First-cmd/SOLAR-ENERGY-MONITORING-AND-MANAGEMENT-SYSTEM-USING-INA228-ON-THE-HOME-ASSISTANT-PLATFORM/SOLAR ENERGY MONITORING AND MANAGEMENT SYSTEM USING INA228 ON THE HOME ASSISTANT PLATFORM#.pdf

The 15th Asia Undergraduate Conference on Computing (AUC²
) 2027

## ระบบตรวจวัดและจัดการพลังงานแสงอาทิตย์ด้วย INA228 บนแพลตฟอร์ม Home Assistant SOLAR ENERGY MONITORING AND MANAGEMENT SYSTEM USING INA228 ON THE HOME ASSISTANT PLATFORM

สิริชัย วงศ์สร้างสรรค์ และ สิทธิโชค อุ่นแก้ว

สาขาวิชาวิศวกรรมคอมพิวเตอร์ คณะวิศวกรรมศาสตร์ มหาวิทยาลัยเทคโนโลยีราชมงคลศรีวิชัย Email: sirichai.u@rmutsvmail.com,sirichai.u@rmutsvmail.com

บทคัดย่อ
โครงงานนี้มีวัตถุประสงค์เพื่อพัฒนาระบบตรวจวัดและจัด การพลังงานแสงอาทิตย์ด้วยเซนเซอร์ร่วมกับระบบผู้ช่วยควบคุม บ้านอัจฉริยะสําหรับติดตามแรงดันไฟฟ้า กระแสไฟฟ้า กําลังไฟฟ้า และพลังงานสะสมของระบบไฟฟ้ากระแสตรง โดยส่ง ข้อมูลจากชุดตรวจวัดไปแสดงผลบนแดชบอร์ด เพื่อให้ผู้ใช้งาน ติดตามสถานะและควบคุมการทํางานของระบบได้ ระบบ ประกอบด้วยส่วนตรวจวัด ส่วนประมวลผล และชุดรีเลย์ควบคุม การเชื่อมต่อระหว่างแบตเตอรี่กับคอนโทรลชาร์จเจอร์รวมถึง ควบคุมโหลดสําหรับใช้พลังงานส่วนเกิน ผู้ใช้งานสามารถเลือก สั่งงานรีเลย์ด้วยตนเองหรือเปิดโหมดจัดการพลังงานส่วนเกิน แบบอัตโนมัติตามเงื่อนไขที่กําหนด การประเมินระบบครอบคลุม การเปรียบเทียบค่าที่วัดได้กับเครื่องมืออ้างอิง การตรวจสอบการ แสดงผลบน ผู้ช่วยควบคุมบ้านอัจฉริยะ และการทดสอบการ ควบคุมรีเลย์ทั้งสองโหมด โดยมุ่งให้ได้ระบบต้นแบบที่ช่วย ติดตามการใช้พลังงานและจัดสรรพลังงานส่วนเกินให้เหมาะสม กับโหลด
คําสําคัญ: พลังงานแสงอาทิตย์, ผู้ช่วยควบคุมบ้านอัจฉริยะ, การ จัดการพลังงาน, พลังงานส่วนเกิน

ABSTRACT
This project aims to develop a solar energy monitoring and management system using the sensor integrated with Home Assistant. The system monitors DC voltage, current, power, and accumulated energy and displays the measurements on a dashboard for status monitoring and control. It consists of sensing and processing units and relays that control the connection between the battery and charge controller, as well as a load for surplus energy utilization. Users can operate the relays manually or enable automatic surplus energy management according to predefined conditions. System evaluation includes comparing measurements with reference instruments, verifying data display in Home Assistant, and testing relay operation in both modes. The intended outcome is a prototype that supports energy monitoring and allocates surplus solar energy to suitable loads.
Keywords: Solar Energy, Home Assistant, Energy Management, Surplus Energy

### 1. บทนํา

พลังงานแสงอาทิตย์เป็นพลังงานทดแทนที่สามารถนํามาใช้ ผลิตไฟฟ้าสําหรับอุปกรณ์และระบบต่าง ๆ ได้ อย่างไรก็ตาม ปริมาณพลังงานที่ผลิตได้เปลี่ยนแปลงตามสภาพแสงและ ช่วงเวลา ขณะที่ความต้องการใช้ไฟฟ้าของโหลดอาจไม่สอดคล้อง กับกําลังการผลิต การตรวจวัดค่าทางไฟฟ้าและการจัด การพลังงานจึงเป็นส่วนสําคัญในการติดตามสถานะของระบบ และวางแผนใช้พลังงานให้เหมาะสม โดยเฉพาะระบบที่มี แบตเตอรี่สําหรับเก็บพลังงานและจ่ายไฟให้โหลดในช่วงที่กําลัง การผลิตไม่เพียงพอ
การตรวจสอบแรงดันไฟฟ้าเพียงอย่างเดียวไม่สามารถแสดง การไหลของพลังงานได้ครบถ้วน จึงควรพิจารณากระแสไฟฟ้า กําลังไฟฟ้า และพลังงานสะสมร่วมด้วย ข้อมูลเหล่านี้ช่วยให้ ผู้ใช้งานทราบสถานะการผลิตและการใช้พลังงาน รวมถึงใช้ ประกอบการกําหนดเงื่อนไขควบคุมโหลด เมื่อระบบมีพลังงาน ส่วนเกิน การนําพลังงานดังกล่าวไปใช้กับโหลดที่เหมาะสมต้อง คํานึงถึงสถานะแบตเตอรี่และเงื่อนไขการทํางานของระบบด้วย โครงงานนี้จึงมุ่งพัฒนาระบบตรวจวัดและจัดการพลังงาน แสงอาทิตย์ด้วยเซนเซอร์ INA228 ร่วมกับ Home Assistant [2] เพื่อรวบรวมและแสดงข้อมูลแรงดันไฟฟ้า กระแสไฟฟ้า กําลังไฟฟ้า และพลังงานสะสมบนแดชบอร์ด พร้อมควบคุมรีเลย์ สําหรับการเชื่อมต่อระหว่างแบตเตอรี่กับคอนโทรลชาร์จเจอร์ และรีเลย์สําหรับโหลดที่ใช้พลังงานส่วนเกิน ผู้ใช้งานสามารถ สั่งงานด้วยตนเองหรือเปิดโหมดจัดการพลังงานส่วนเกินแบบ อัตโนมัติตามเงื่อนไขที่กําหนด และเมื่อค่าแรงดันแบตเตอรี่ถึง 10v esp32 จะทําการสั่งตัดโหลดทําให้สามารถรักษาระดับ แรงดันแบตเตอรี่ตํ่าสุดไว้ที่ประมาณ 10v ตามผลการทดลองที่ 4.3
การพัฒนาระบบมีเป้าหมายเพื่อให้ผู้ใช้งานติดตามค่าทาง ไฟฟ้าและควบคุมการใช้พลังงานผ่านศูนย์กลางเดียว [1] โดย ประเมินความถูกต้องของการตรวจวัดเทียบกับเครื่องมืออ้างอิง ตรวจสอบการแสดงผลบน Home Assistant และทดสอบการ ทํางานของรีเลย์ทั้งแบบสั่งงานด้วยตนเองและแบบอัตโนมัติ เพื่อ ประเมินความเหมาะสมของระบบต้นแบบก่อนนําไปใช้งานจริง

### 2. การออกแบบ

ระบบตรวจวัดและจัดการพลังงานแสงอาทิตย์ด้วย INA228 บนระบบ Home Assistant ออกแบบให้ประกอบด้วย 3 ส่วน ได้แก่ ส่วนตรวจวัดค่าพลังงานไฟฟ้าจากโซล่าเซลล์ส่วน ประมวลผลและสื่อสารข้อมูล และส่วนควบคุมการใช้พลังงาน โดยใช้รีเลย์และ ACS712 โดยนําข้อมูลจากชุดตรวจวัดมา แสดงผลให้ผู้ใช้งานสามารถติดตามสถานะและเลือกโหมดการ ควบคุมผ่านแดชบอร์ดของ Home Assistant

### 2.1 ส่วนตรวจวัดค่าพลังงานไฟฟ้าจากโซล่าเซลล์

ส่วนตรวจวัดใช้เซนเซอร์ INA228 สําหรับตรวจวัด กระแสไฟฟ้าในวงจรกระแสตรง โดยอ่านค่าแรงดันไฟฟ้าและ กระแสไฟฟ้าที่ไหลผ่านคอนโทรลชาร์จเจอร์เพื่อนําไปคํานวณ กําลังไฟฟ้า ส่วนตําแหน่งติดตั้งชุดตรวจวัดต้องสอดคล้องกับจุดที่ ต้องการติดตามการไหลของพลังงาน เพื่อให้ข้อมูลที่ได้สามารถ นําไปใช้กําหนดเงื่อนไขควบคุมได้อย่างเหมาะสม

### 2.2 ส่วนควบคุมการใช้พลังงาน โดยใช้รีเลย์และ ACS712

ระบบใช้รีเลย์ 1 สําหรับควบคุมการเชื่อมต่อระหว่าง คอนโทรลชาร์จเจอร์กับโซล่าเซลล์และใช้รีเลย์ 2 สําหรับควบคุม โหลดที่นําพลังงานส่วนเกินหรือพลังงานจากแบตเตอรี่ไปใช้งาน โดยรีเลย์ 2 สามารถรับคําสั่งจากผู้ใช้งานได้โดยตรง หรือทํางาน ตามเงื่อนไขของโหมดอัตโนมัติ และเซนเซอร์ ACS712 จะทําการ วัดกระแสที่ไหลผ่านโหลดจากรีเลย์ 2 การเลือกรีเลย์ต้องให้พิกัด แรงดันและกระแสของหน้าสัมผัสเหมาะสมกับวงจรและโหลดที่ ควบคุม

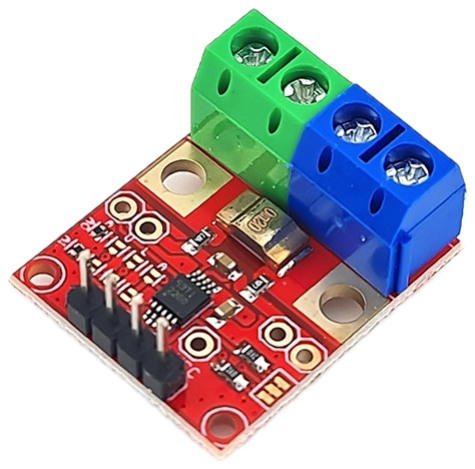
[picture p1: figure]

ภาพ 1 INA228
ที่มา : https://www.modulemore.com/product/2856/ina228-20bit-high-precision-power-monitor-85v

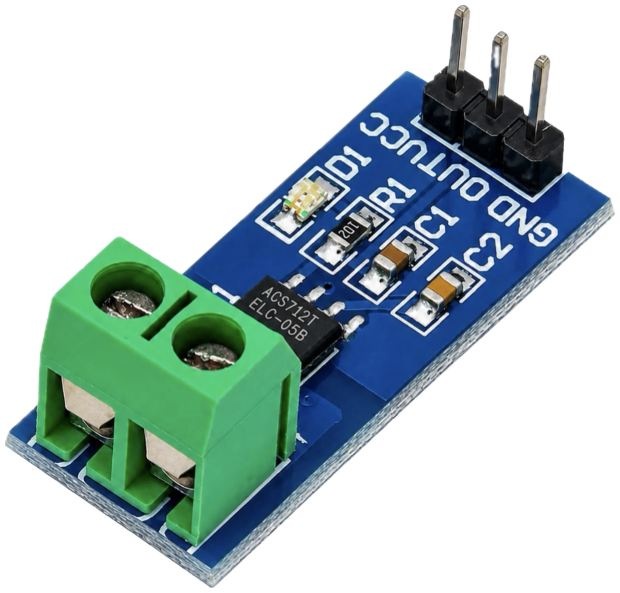
[picture p2: figure]

ภาพ 2 ACS712
ที่มา : https://robu.in/product/5a-range-current-sensormodule-acs712/

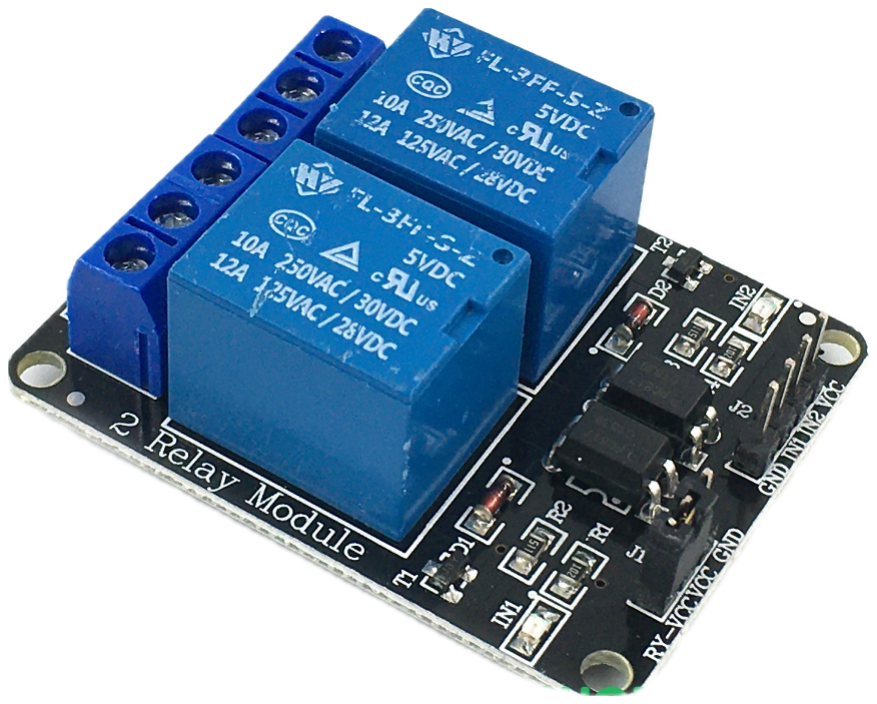
[picture p3: figure]

ภาพ 3 relay 5v 2 channel
ที่มา : https://www.ortechonline.com/product/1893/%E0%B8%9A%E0%B8%AD %E0%B8%A3%E0%B9%8C%E0%B8%94-esp32-38pinesp32s-chip-cp2102-wifi-bluetooth-board-esp-wroom-32-nodemcu-38%E0%B8%82%E0%B8%B2-expansionboard-

### 2.3 ส่วนประมวลผลและสื่อสารข้อมูล

ส่วนประมวลผลทําหน้าที่อ่านข้อมูลจาก INA228 ผ่านการ สื่อสารแบบ I²C และ ACS712 แบบอนาล็อก เข้า esp32 ส่งค่าที่ ตรวจวัดไปยัง Home Assistant ผ่าน MQTT การออกแบบต้อง คํานึงถึงความต่อเนื่องของข้อมูลและการตรวจสอบสถานะการ เชื่อมต่อ เพื่อป้องกันการสั่งงานที่ผิดพลาด

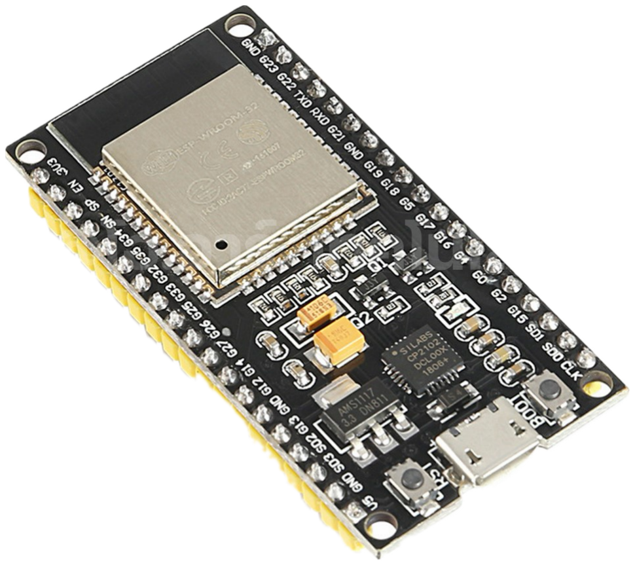
[picture p4: figure]

ภาพ 4 esp32 38pin

ที่มา : https://www.artronshop.co.th/product/188/%E0%B8%9A%E0%B8%AD%E0%B8%A3%E0%B9%8C%E0%B8%94%E0%B8%A3%E0%B8%B5%E0%B9%80%E0 %B8%A5%E0%B8%A2%E0%B9%8C-5v-2-%E0%B8%8A%E0%B9%88%E0%B8%AD%E0%B8%87-%E0%B8%A1%E0%B8%B5%E0%B8%A3%E0%B8%B9% E0%B8%A2%E0%B8%B6%E0%B8%94%E0%B8%99%E0 %B9%8A%E0%B8%AD%E0%B8%95

### 2.4 การจัดการพลังงานส่วนเกิน

การออกแบบโหมดอัตโนมัติโดยใช้ค่าแรงดันไฟฟ้าของ แบตเตอรี่พิจารณาการเปิดหรือปิดระบบชาร์จแบตเตอรี่และ โหลดผ่านรีเลย์1 และ 2 โดยกําหนดเงื่อนไขให้เหมาะสมกับชนิด ของแบตเตอรี่ที่ใช้

### 2.5 การแสดงผลบน Home Assistant

แดชบอร์ดออกแบบให้แสดงค่าทางไฟฟ้าปัจจุบัน และกราฟ ข้อมูลย้อนหลัง สถานะรีเลย์ และสถานะโหมดจัดการพลังงาน ส่วนเกิน พร้อมปุ่มสําหรับสั่งงานรีเลย์และเลือกโหมดควบคุม การจัดวางข้อมูลมุ่งให้ผู้ใช้งานเห็นสถานะการวัดและการควบคุม ในหน้าเดียว เพื่อช่วยติดตามการทํางานและตรวจสอบผลของ คําสั่งที่ส่งไปยังอุปกรณ์

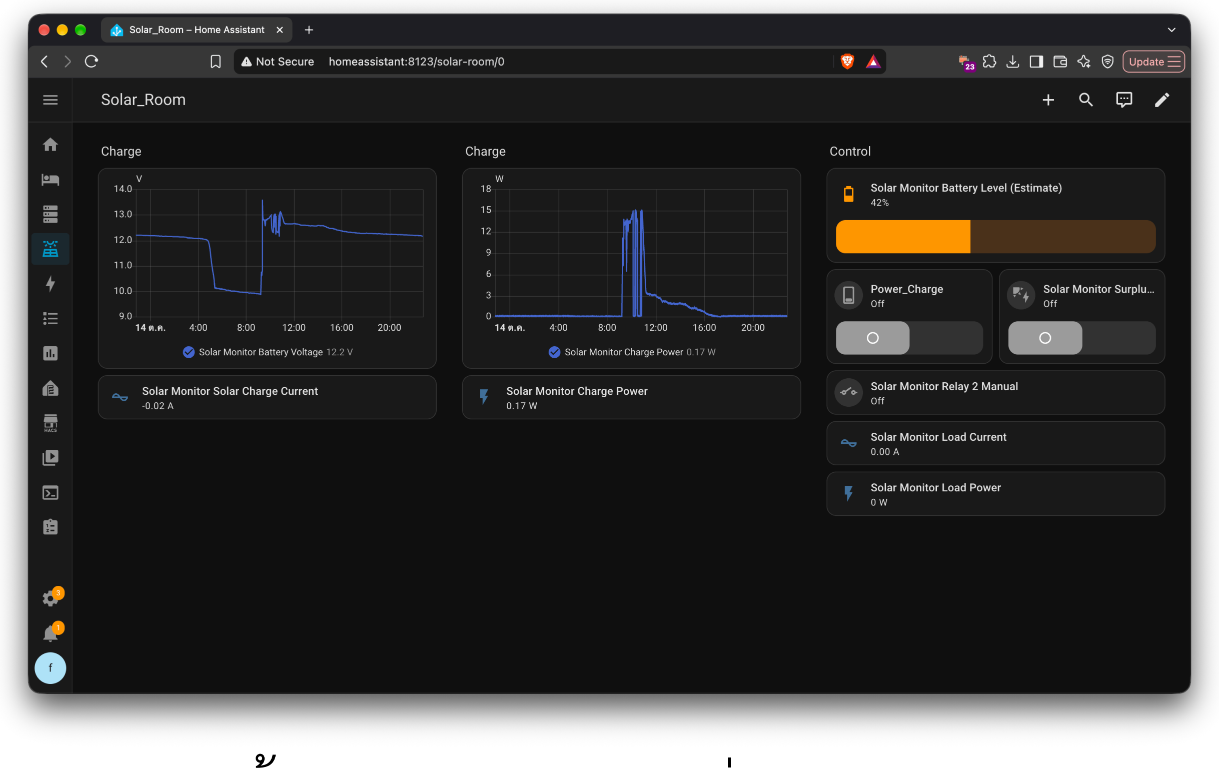
[picture p5: figure]

ภาพ 5 หน้าควบคุมและแสดงค่าบน home assistant

### 2.6 การออกแบบทางอิเล็กทรอนิกส์

ส่วนประกอบอิเล็กทรอนิกส์ของระบบตรวจวัดและจัด การพลังงานแสงอาทิตย์ ในแผนภาพเค้าร่างวงจร (Circuit Schematic) ดังภาพ 2 และลายแผ่นงจรพิมพ์(Printed Circuit

Board: PCB) ดังภาพ 3 ซึ่งถูกออกแบบโดยใช้โปรแกรมอีซี่อีดีเอ (EasyEDA)

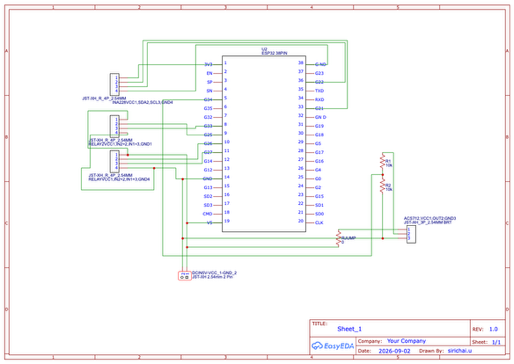
[picture p6: figure]

ภาพ 6 แผนภาพวงจรเค้าร่าง

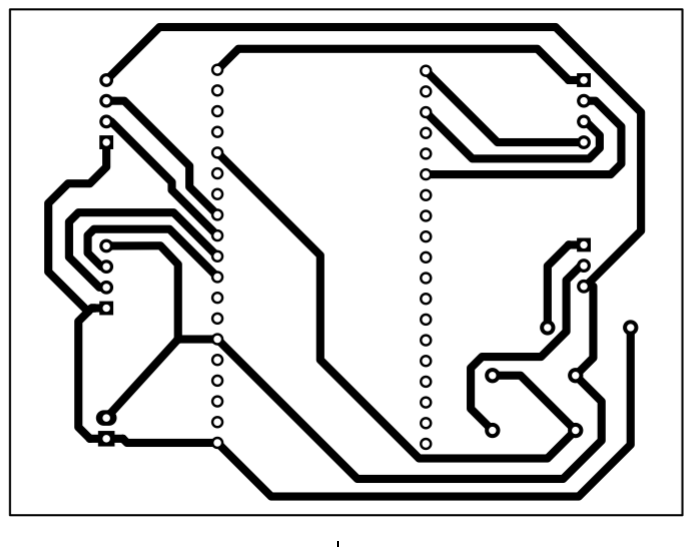
[picture p7: figure]

ภาพ 7 แผ่นลายวงจร

### 3. ระบบตรวจวัดและจัดการพลังงานแสงอาทิตย์

### 3.1 การสร้างแผ่นวงจรพิมพ์

การสร้างแผ่นวงจรพิมพ์สําหรับระบบตรวจวัดและจัด การพลังงานแสงอาทิตย์เริ่มจากการนําลายวงจรที่ออกแบบที่ ออกแบบไว้ดังภาพ 7 ในหัวข้อ มาพิมพ์ลงบนกระดาษโฟโต้ด้วย เครื่องพิมพ์เลเซอร์ดังภาพ 8 จากนั้นนํากระดาษลายวงจรมาลอก ลายวงจรสู่แผ่นทองแดงโดยการใช้ความร้อนจากเตารีดผ้าดัง ภาพ 9 หากวงจรไม่สมบูรณ์ให้นําปากกาเขียนวงจรมาวาดลาย วงจรให้สมบูรณ์ดังภาพ 10 นําแผ่นที่ลอกลายสมบูรณ์แล้วมากัด ลายวงจรดังภาพ 11 เมื่อเสร็จแล้วให้นํานํ้ายาล้างเล็บ ในการ ลอกลายหมึกที่เหลือออกเพื่อให้เห็นชั้นทองแดงที่ออกมาเป็นลาย วงจร และทําการเจาะรูและติดตั้งอุปกรณ์ต่างๆลงบนแผ่นวงจร ดังภาพ 12

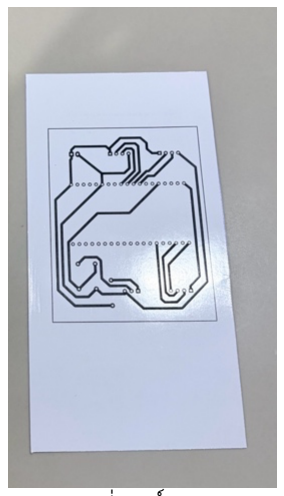
[picture p8: figure]

ภาพ 8 ลายวงจรที่พิมพ์ลงบนกระดาษโฟโต้

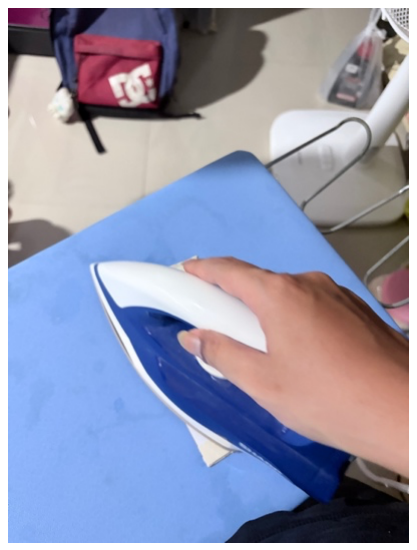
[picture p9: figure]

ภาพ 9 รีดลายวงจร

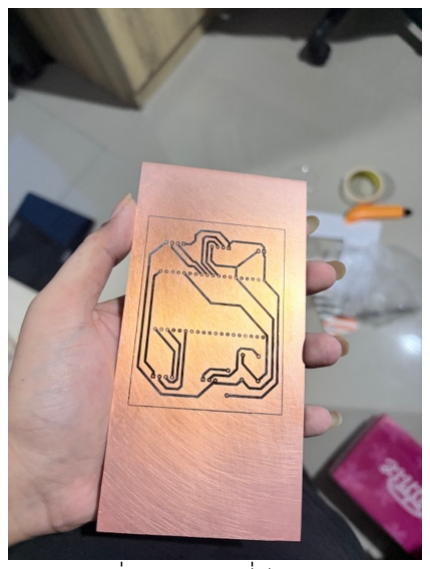
[picture p10: figure]

ภาพ 10 แผ่นทองแดงที่มีลายวงจรติดอยู่

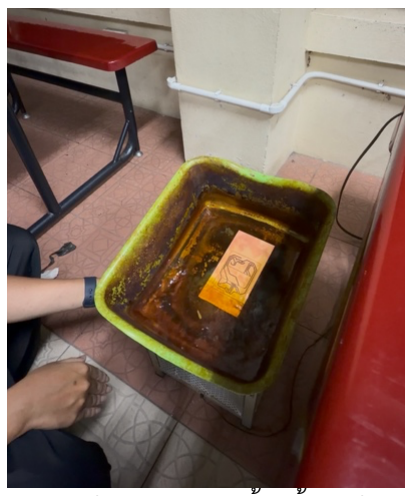
[picture p11: figure]

ภาพ 11 กัดลายทองแดงด้วยนํ้ายากัดวงจร

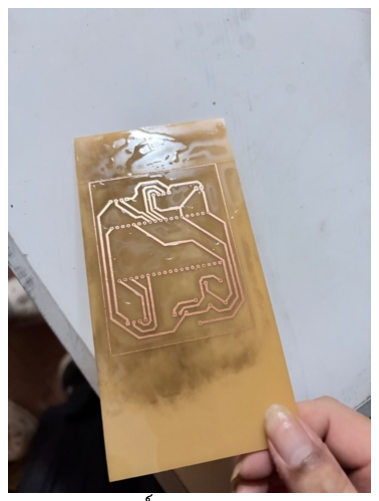
[picture p12: figure]

ภาพ 12 ผลลัพธ์จากการกัดลายทองแดง

### 3.2 การติดตั้งอุปกรณ์บนแผ่นวงจรพิมพ์

เมื่อได้แผ่นวงจรพิมพ์แล้วนํามาเจาะรูตามที่กําหนดไว้โดยใช้ ดอกสว่านขนาด 1 มิลลิเมตรเพื่อให้สามารถใส่ขาอุปกรณ์ต่างๆ ตามที่ได้กําหนดไว้ในวงจรดังภาพ 13 และทําการบัดกรีเพื่อ ติดต่ออุปกรณ์ภายนอกดังภาพ 14

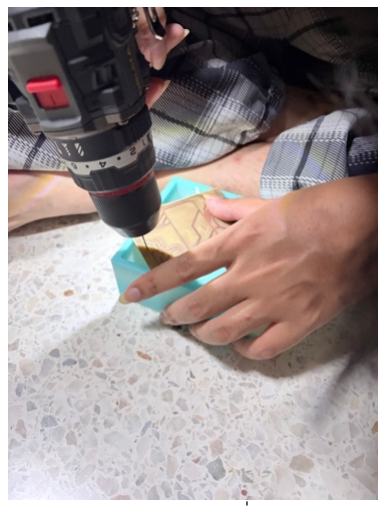
[picture p13: figure]

ภาพ 13 เจาะรูแผ่นวงจร

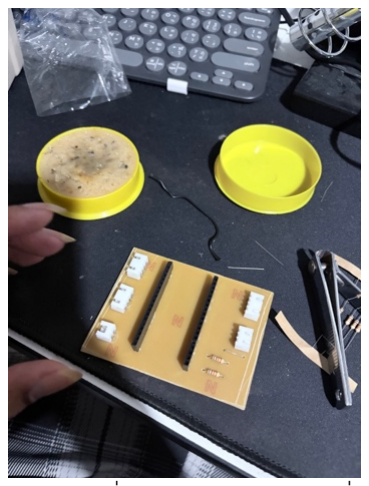
[picture p14: figure]

ภาพ 14 นําขาต่อมาเสียบตามรูของแผ่นวงจร

### 3.3 การติดตั้งและเชื่อมต่ออุปกรณ์ต่างๆ

การนําโมดูลและเซนเซอร์ที่ใช้ในโปรเจกต์มาจัดวางลงใน กล่องเก็บอุปกรณ์ดังภาพ 15 เพื่อความเป็นระเบียบและ ปลอดภัยต่อการนําไปใช้งานดังภาพ

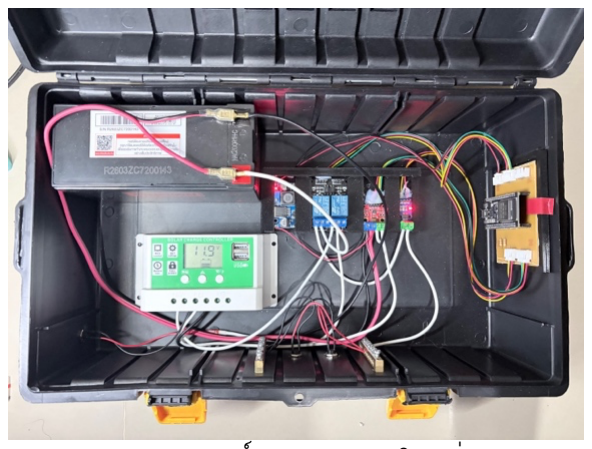
[picture p15: figure]

ภาพ 15 องค์ประกอบภายในกล่อง

### 4. ผลการทดสอบ 4.1 ผลการทดสอบค่ากําลังไฟฟ้าที่ผลิตได้จากโซล่าเซลล์

จากภาพ 16 ค่ากําลังไฟฟ้าที่สามารถผลิตได้เยอะสุดคือ ช่วงเวลา 10:00-11:00น.อยู่ที่ประมาณ 12-18w

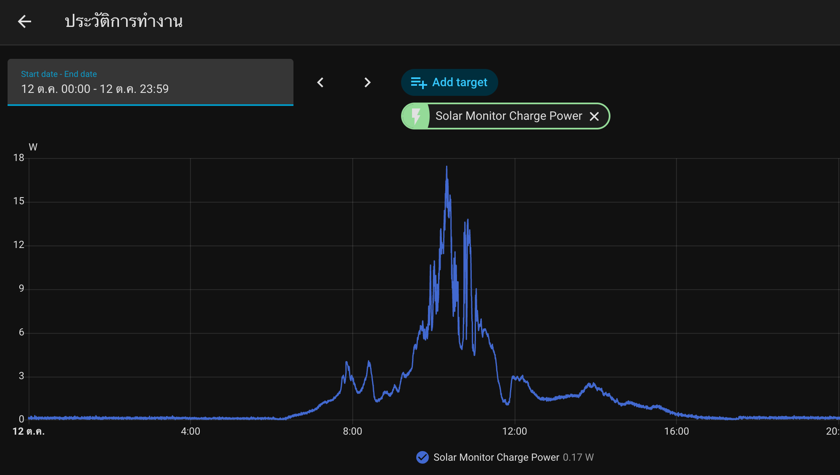
[picture p16: figure]

ภาพ 16 ค่ากําลังไฟฟ้าวันที่ 12/10/26

### 4.2 ผลการทดสอบระบบป้องการแรงดันแบตเตอรี่

จากภาพ 17 เมื่อค่าแรงดันแบตเตอรี่ถึง 10 v esp32 จะทํา การสั่งตัดโหลดทําให้สามารถรักษาระดับแรงดันแบตเตอรี่ตํ่าสุด ไว้ที่ประมาณ 10 v

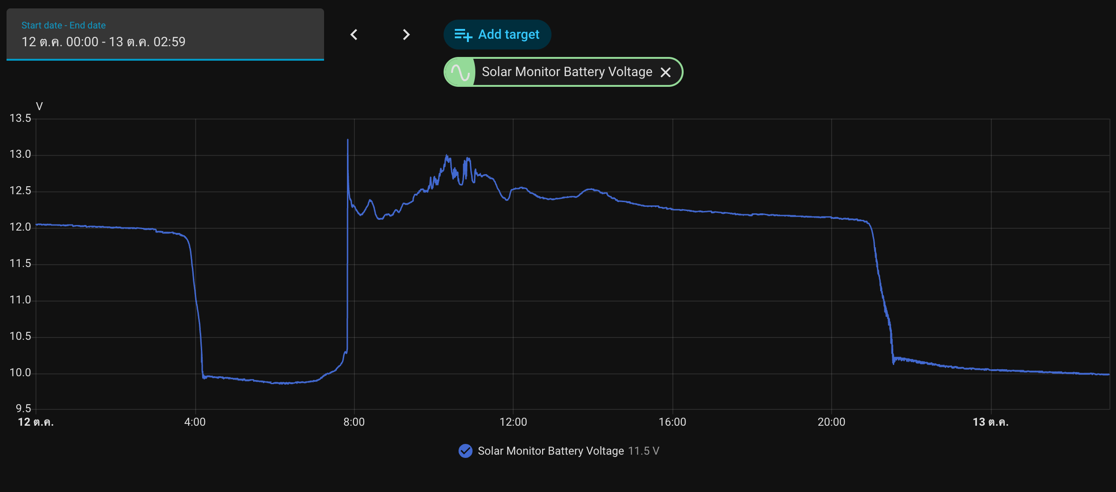
[picture p17: figure]

ภาพ 17 ค่าแรงดันแบตเตอรี่วันที่ 12-13/10/26

### 4.3 ผลการทดสอบส่งข้อมูลจากเซนเซอร์ไปยังแพลตฟอร์ม

จากภาพ 17 home assistant สามารถแสดงค่าข้อมูลที่ส่ง จาก esp32 ที่ส่งค่าผ่านทาง Mqtt และยังสามารถควบคุมการ สั่งงานรีเลย์ได้ทั้ง 2 ตัวและเป็นไปตามเงื่อนไขที่ได้ตั้งเอาไว้ สําหรับการสั่งงานรีเลย์

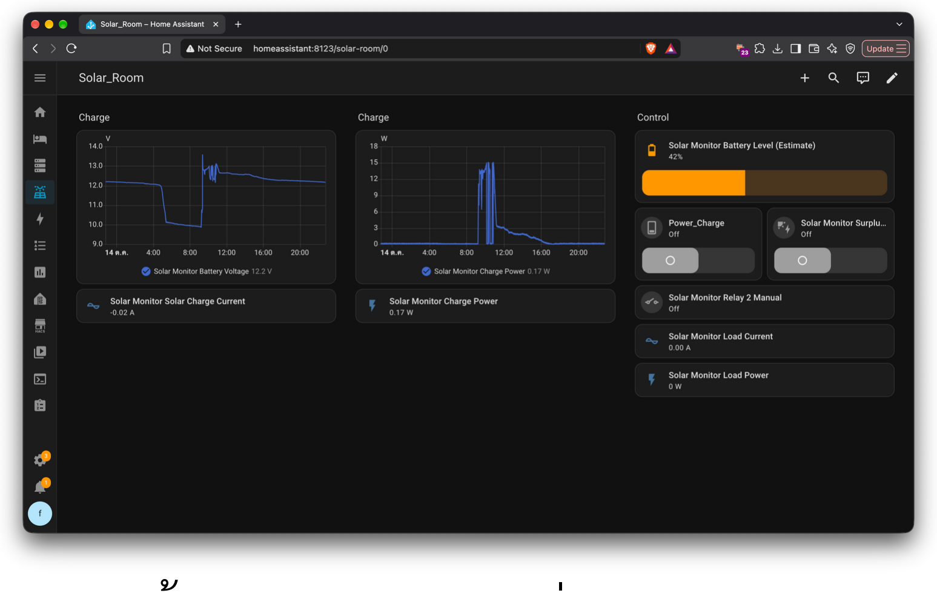
[picture p18: figure]

ภาพ 18 หน้าควบคุมและแสดงค่าบน home assistant

### 4.4 ผลการทดสอบการดึงพลังงานออกไปใช้งาน

จากตาราง 1 แบตเตอรี่ขนาด 7.2 Ah สามารถรักษาโหลดที่ มีขนาดไม่เกิน 10 w ได้ประมาณ 4 ชั่วโมง

ตาราง 1 ผลการทดสอบการดึงพลังงานออกไปใช้งาน
อุปกรณ์ | ค่ากําลังไฟที่ใช้ | เวลาที่ใช้งานได้
เครื่องฟอกอากาศ | 5-8w | 4 ชั่วโมง
อุปกรณ์ชาร์จมือถือ | 30-60w | 1ชั่วโมง

### 5. สรุปผลการทดสอบ

โครงงานระบบตรวจวัดและจัดการพลังงานแสงอาทิตย์ด้วย INA228 ตรวจวัดค่าทางไฟฟ้าระหว่างชาร์จเจอร์กับแบตเตอรี่ และใช้ ACS712 ตรวจวัดกระแสโหลดหลังรีเลย์ 2 โดย ESP32 ทําหน้าที่อ่านค่าและส่งข้อมูลผ่าน MQTT ไปแสดงผลบน Home Assistant พร้อมรับคําสั่งควบคุมรีเลย์จากผู้ใช้งาน การควบคุมตามเงื่อนไขแรงดันกําหนดให้รีเลย์ 1 ตัดการ เชื่อมต่อระหว่างแผงโซลาร์เซลล์กับชาร์จเจอร์เมื่อแรงดันตั้งแต่ 15.0 โวลต์ขึ้นไปต่อเนื่อง 5 วินาที และอนุญาตให้เชื่อมต่อกลับ เมื่อแรงดันไม่เกิน 12.8 โวลต์ หลังพักอย่างน้อย 10 นาที โดย ต้องไม่มีคําสั่งปิดค้างจากผู้ใช้งาน ส่วนโหมดจัดการพลังงาน ส่วนเกินกําหนดให้รีเลย์ 2 เปิดโหลดเมื่อแรงดันตั้งแต่ 14.2 โวลต์ ขึ้นไปต่อเนื่อง 3 นาที และปิดโหลดเมื่อแรงดันไม่เกิน 12.7 โวลต์ ต่อเนื่อง 30 วินาที นอกจากนี้ เมื่อแรงดันตํ่ากว่า 10 โวลต์ ระบบ จะตัดโหลดในรอบตรวจวัดที่พบเงื่อนไข และปลดการระงับโหลด เมื่อแรงดันสูงกว่า 12.5 โวลต์ เพื่อกลับไปพิจารณาคําสั่งหรือ เงื่อนไขของโหมดที่ใช้งาน และแบตเตอรี่ขนาด 7.2 Ah สามารถ นําไปสํารองใช้งานกับกําลังโหลดไฟ 10 w ได้ประมาณ 4 ชั่วโมง เงื่อนไขดังกล่าวเป็นเกณฑ์สําหรับประเมินการทํางานของ ระบบต้นแบบ โดยยังต้องนําค่าที่วัดได้จริง เวลาในการตอบสนอง ของรีเลย์ และผลการแสดงข้อมูลบน Home Assistant มา ประกอบการสรุปผล จึงจะสามารถยืนยันความถูกต้องของการ ควบคุมและความแม่นยําของระบบได้

กิตติกรรมประการ
ขอขอบคุณสาขาวิศวกรรมคอมพิวเตอร์หลักสูตรวิศวกรรม คอมพิวเตอร์คณะวิศวกรรมศาสตร์มหาวิทยาลัยเทคโนโลยีราช มงคลศรีวิชัยในการสนับสนุนให้ร่วมนําเสนองานวิจัยครั้งนี้

คําชี้แจ้งการใช้ AI
ต้นฉบับนี้มีเนื้อหาที่สร้างขึ้นหรือได้รับการสนับสนุนจาก เครื่องมือปัญญาประดิษฐ์(AI) ได้แก่ CHATGPT, Claude ซึ่งถูก เอกสารอ้างอิง
[1] WENNO, L. A., MANUEL PUNUH, E., BUDIMAN, M. J., SOPHIE PONGOH, D., LESNUSSA, H. A. B., & GESURI DAUD, J. (2025). A PROTOTYPE OF AN IOT BASE VOLTAGE PROTECTION SYSTEM FOR BATTERIES. IN 2025 INTERNATIONAL CONFERENCE ON INFORMATICS, MULTIMEDIA, CYBER AND INFORMATION SYSTEM (ICIMCIS) (PP. 415–420). IEEE. HTTPS://DOI.ORG/10.1109/ICIMCIS68501.2025.1132735 9
[2] HOME ASSISTANT, “HOME ASSISTANT: OPEN SOURCE HOME AUTOMATION THAT PUTS LOCAL CONTROL AND PRIVACY FIRST,” OPEN HOME FOUNDATION. [ONLINE]. AVAILABLE: HTTPS://WWW.HOME-ASSISTANT.IO/. [ACCESSED: 31-OCT-2026].
